sambazley/reflow-oven/oven.kicad_pcb

## KiCad design oven.kicad_pcb (2020-09-24)

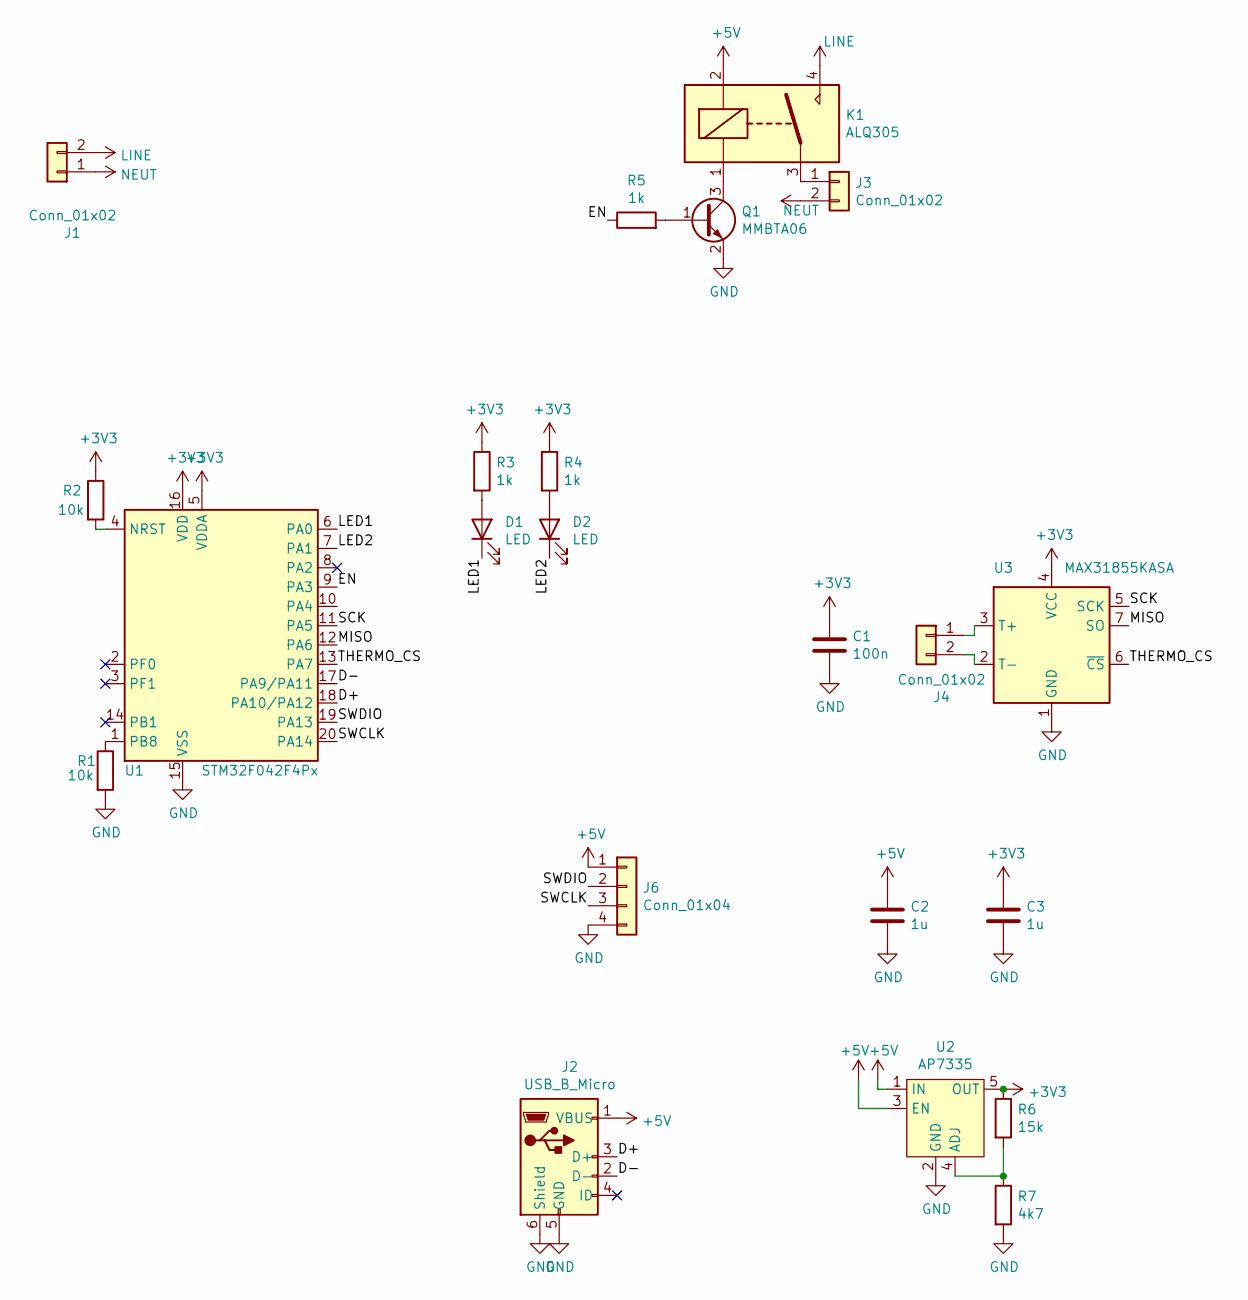
[picture p1: schematic oven.kicad_sch]

Parts:
C1: 100n; C_0805_2012Metric
C2, C3: 1u; C_0805_2012Metric
D1, D2: LED; LED_0805_2012Metric
J1, J3: Conn_01x02; JST_VH_B2P3-VH_1x02_P7.92mm_Vertical
J2: USB_B_Micro; USB_Micro-B_Amphenol_10118194-0001LF
J4: Conn_01x02; JST_VH_B2P-VH_1x02_P3.96mm_Vertical
J6: Conn_01x04; PinHeader_1x04_P2.54mm_Vertical
K1: ALQ305
Q1: MMBTA06; SOT-23
R1, R2: 10k; R_0805_2012Metric
R3, R4, R5: 1k; R_0805_2012Metric
R6: 15k; R_0805_2012Metric
R7: 4k7; R_0805_2012Metric
U1: STM32F042F4Px; TSSOP-20_4.4x6.5mm_P0.65mm
U2: AP7335; SOT-23-5
U3: MAX31855KASA; SOIC-8_3.9x4.9mm_P1.27mm

Connections:
+3V3: C1.1, C3.1, R2.1, R3.1, R4.1, R6.1, U1.5 (VDDA), U1.16 (VDD), U2.5 (OUT), U3.4 (VCC)
+5V: C2.1, J2.1 (VBUS), J6.1, K1.2, U2.1 (IN), U2.3 (EN)
/D+: J2.3 (D+), U1.18 (PA10/PA12)
/D-: J2.2 (D-), U1.17 (PA9/PA11)
/EN: R5.1, U1.9 (PA3)
/LED1: D1.1 (K), U1.6 (PA0)
/LED2: D2.1 (K), U1.7 (PA1)
/MISO: U1.12 (PA6), U3.7 (SO)
/SCK: U1.11 (PA5), U3.5 (SCK)
/SWCLK: J6.3, U1.20 (PA14)
/SWDIO: J6.2, U1.19 (PA13)
/THERMO_CS: U1.13 (PA7), U3.6 (~CS~)
GND: C1.2, C2.2, C3.2, J2.5 (GND), J2.6 (Shield), J6.4, Q1.2 (E), R1.2, R7.2, U1.15 (VSS), U2.2 (GND), U3.1 (GND)
LINE: J1.2, K1.4
NEUT: J1.1, J3.2
unnamed: D1.2 (A), R3.2
unnamed: D2.2 (A), R4.2
unnamed: J3.1, K1.3
unnamed: J4.1, U3.3 (T+)
unnamed: J4.2, U3.2 (T-)
unnamed: K1.1, Q1.3 (C)
unnamed: Q1.1 (B), R5.2
unnamed: R1.1, U1.1 (PB8)
unnamed: R2.2, U1.4 (NRST)
unnamed: R6.2, R7.1, U2.4 (ADJ)

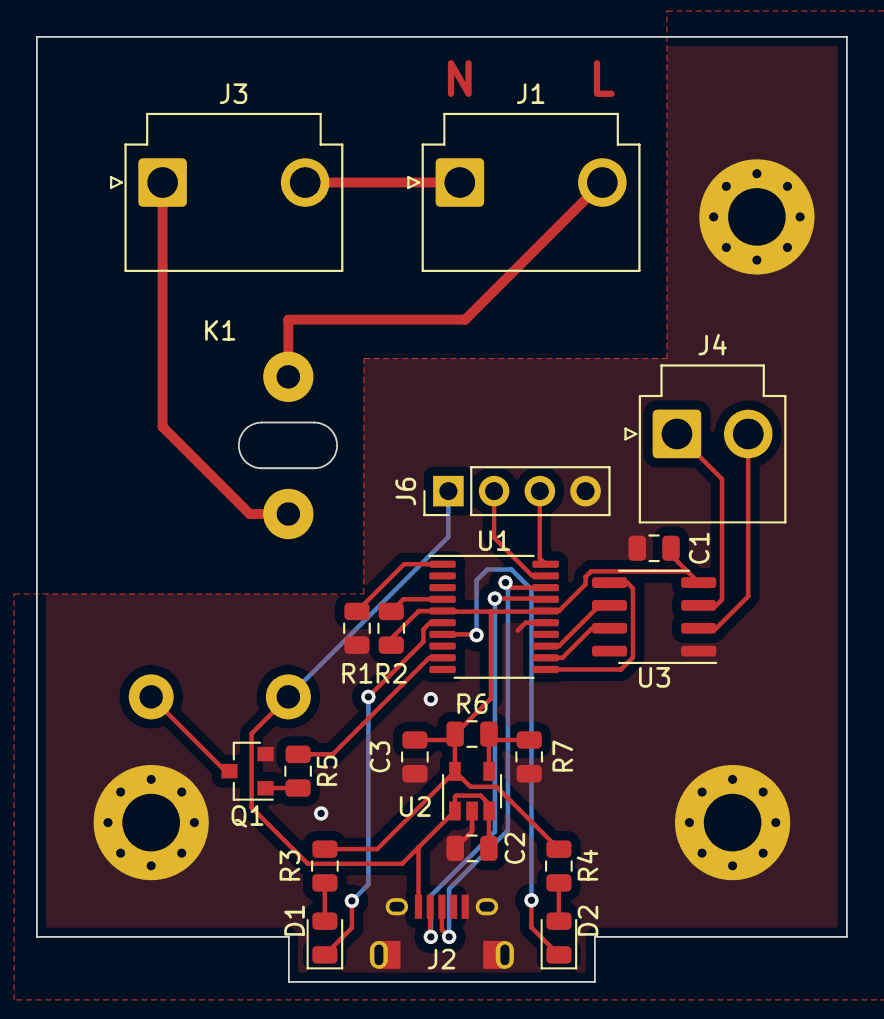
[picture p2: board oven.kicad_pcb from above]

Board: 2 copper layers, 45.0 x 52.5 mm, 22 parts (0 on the bottom side), 25 nets.
