sambazley/reflow-oven/(commit log)

2020-09-24 Add PCB design files
    [oven.kicad_pcb, oven.kicad_sch]
2020-09-24 Add STM32 code
    [flash.cfg]
2020-11-20 Correct vector table for STM32F0
2021-06-18 Implement USB driver and PID controller
2021-06-19 Disable oven if ovenctl doesn't acknowledge
    [oven.c, usb.c]
2021-06-19 Add command to query current temperature
2021-06-20 Flush spi_thermo when querying temperature
